petedelery2006/O.R.B.I.T-Project/hardware/models/README.md

# Current models: [O.R.B.I.T. 1.0](1.0/README.md)

The three models below are retained from the earlier prototype.

# Prototype models

Original STL data is preserved unchanged; filenames are simplified for repository use.

| Repository file | Original uploaded filename | Triangles |
| --- | --- | ---: |
| [prototype-floor.stl](prototype-floor.stl) | O.R.B.I.T 8 sensor prototype(floor)).stl | 6,740 |
| [prototype-front-wall.stl](prototype-front-wall.stl) | O.R.B.I.T 8 sensor prototype(front wall).stl | 1,034 |
| [sensor-test-tower.stl](sensor-test-tower.stl) | O.R.B.I.T sensor test tower.stl | 7,810 |

Each file passed a basic binary STL length/triangle-count check. This is not a printability, watertightness, dimensional accuracy, or mechanical-fit validation. STL files do not encode a standard physical unit; confirm scale in the slicer. Print settings, material, and editable source CAD files were not supplied.
