petedelery2006/O.R.B.I.T-Project/hardware/pcb/README.md

# Fan-control PCB

- [FAN control PCB1.pcb](FAN%20control%20PCB1.pcb) — supplied Pad2Pad design.
- [FAN control PCB1.bak](FAN%20control%20PCB1.bak) — supplied backup.

Both original files are preserved unchanged. Their SHA-256 hashes match in this snapshot. The file header identifies Pad2Pad; no schematic, Gerbers, fabrication rules check, or electrical validation was supplied. The parts notes separately report two protoboards for power rails and one for motor control; the files do not establish whether this PCB has been fabricated or installed.
