petedelery2006/O.R.B.I.T-Project/hardware/models/1.0/README.md

# O.R.B.I.T. 1.0 enclosure

Nine original binary STL files, preserved unchanged from the supplied files.

| Part / original filename | Triangles |
| --- | ---: |
| [O.R.B.I.T 1.0 (BACK WALL).stl](O.R.B.I.T%201.0%20%28BACK%20WALL%29.stl) | 1356 |
| [O.R.B.I.T 1.0 (BATTERY BASE).stl](O.R.B.I.T%201.0%20%28BATTERY%20BASE%29.stl) | 2652 |
| [O.R.B.I.T 1.0 (CONNECTER).stl](O.R.B.I.T%201.0%20%28CONNECTER%29.stl) | 3242 |
| [O.R.B.I.T 1.0 (FAN MOUNTS).stl](O.R.B.I.T%201.0%20%28FAN%20MOUNTS%29.stl) | 6144 |
| [O.R.B.I.T 1.0 (FRONT WALL).stl](O.R.B.I.T%201.0%20%28FRONT%20WALL%29.stl) | 15246 |
| [O.R.B.I.T 1.0 (LEFT WALL).stl](O.R.B.I.T%201.0%20%28LEFT%20WALL%29.stl) | 13714 |
| [O.R.B.I.T 1.0 (RIGHT WALL).stl](O.R.B.I.T%201.0%20%28RIGHT%20WALL%29.stl) | 844 |
| [O.R.B.I.T 1.0 (ROOF).stl](O.R.B.I.T%201.0%20%28ROOF%29.stl) | 830 |
| [O.R.B.I.T 1.0(BASE).stl](O.R.B.I.T%201.0%28BASE%29.stl) | 10146 |

All nine files passed binary STL length/triangle-count checks. STL has no standard physical unit; verify scale in the slicer. Material, orientation, supports, tolerances, and assembly fit have not been validated. Editable CAD source was not supplied.

The supplied spelling “CONNECTER” is retained. [Earlier prototype designs](../README.md) remain available for historical reference.
