petedelery2006/O.R.B.I.T-Project/docs/sensors-current.md

Parts

[Gas and Air Quality sensor](https://www.amazon.com/gp/product/B0B389LQCQ/ref=ewc_pr_img_16?smid=A1GMZO8N77UCMQ&psc=1)✅

[humidity sensor](https://www.amazon.com/Precision-Temperature-Humidity-Measurement-Communication/dp/B0F1JWWFT7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)✅

[magnetometer sensor](https://www.amazon.com/HiLetgo-LSM303DLHC-Compass-Accelerometer-Magnetometer/dp/B07X3GFKYD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)✅

[Arduino 2560](https://www.amazon.com/dp/B01H4ZLZLQ?ref=ppx_yo2ov_dt_b_fed_asin_title&th=1)✅

[16x02 LCD screen](https://www.amazon.com/dp/B0BWTFN9WF?ref=ppx_yo2ov_dt_b_fed_asin_title&th=1)3x✅

[ELEGOO 0.96 Inch OLED Display](https://www.amazon.com/dp/B0D2RMQQHR?ref=ppx_yo2ov_dt_b_fed_asin_title&th=1)2x✅

[Arduino Uno ATmega+328P ATMEGA+16U2](https://www.amazon.com/ELEGOO-Board-ATmega328P-ATMEGA16U2-Compliant/dp/B01EWOE0UU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)2x✅

[30mm Fan 5V](https://www.amazon.com/gp/product/B0792BW2VH/ref=ewc_pr_img_3?smid=A35AFW9EVJYR0N&th=1)2x✅

[6 Pin switch](https://www.amazon.com/gp/product/B0799NSBHY/ref=ewc_pr_img_9?smid=A2NNH5C5IP9N3O&th=1)✅

[12V/24V to 5V 5A 25W Buck Converter Power Regulator](https://www.amazon.com/gp/product/B0CSPTCT2H/ref=ewc_pr_img_11?smid=A2VHHX0QRT6DTE&th=1)2x✅                           

[Barometric Pressure and Altitude Sensor](https://www.amazon.com/gp/product/B013W0RR6Y/ref=ewc_pr_img_14?smid=AM0JQO74J587C&psc=1)✅

[5V 5AH Deep Cycle Battery](https://www.amazon.com/gp/product/B0FCG41L1H/ref=ewc_pr_img_11?smid=A2FTK1Z152QK5G&th=1)✅

[Visible Spectrum Infrared Color Spectrometer Sensor](https://www.amazon.com/gp/product/B0DBQKDV67/ref=ewc_pr_img_12?smid=A1ASY00QOMN6RD&psc=1)✅

[Fast-Blow Glass Fuses 4 amp](https://www.amazon.com/gp/product/B07WTVGSCF/ref=ox_sc_saved_title_5?smid=A2RFXKS6GNXFWP&th=1)✅

[RGB LED](https://github.com/petedelery2006/O.R.B.I.T-Project)✅

[Buzzer](https://github.com/petedelery2006/O.R.B.I.T-Project)✅

[INA219](https://www.amazon.com/dp/B07VL8NY32?ref=ppx_yo2ov_dt_b_fed_asin_title)✅

[2.42 inches 128x64 IIC I2C OLED](https://www.amazon.com/dp/B0G2RFLG1L?ref=ppx_yo2ov_dt_b_fed_asin_title&th=1)✅

[Mini Momentary Push Button](https://www.amazon.com/dp/B083JWJPW5?ref=ppx_yo2ov_dt_b_fed_asin_title&th=1)2x✅

2 PROTO Boards were used for power rails

1 PROTO Board was used for motor control
