petedelery2006/O.R.B.I.T-Project/docs/sensors-original.md

Parts

[Gas and Air Quality sensor](https://www.amazon.com/gp/product/B0B389LQCQ/ref=ewc_pr_img_16?smid=A1GMZO8N77UCMQ&psc=1)(not purchased)

[humidity sensor](https://www.amazon.com/Precision-Temperature-Humidity-Measurement-Communication/dp/B0F1JWWFT7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) and temp(tested in prototype)

[magnetometer sensor](https://www.amazon.com/HiLetgo-LSM303DLHC-Compass-Accelerometer-Magnetometer/dp/B07X3GFKYD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)(tested in prototype)

[O2 sensor](https://www.amazon.com/gp/product/B08BL1NLGV/ref=ewc_pr_img_4?smid=A2EH5PO307BR7O&th=1)(not purchased)

[Arduino 2560](https://www.amazon.com/dp/B01H4ZLZLQ?ref=ppx_yo2ov_dt_b_fed_asin_title&th=1)(tested in prototype)

[16x02 LCD screen](https://www.amazon.com/dp/B0BWTFN9WF?ref=ppx_yo2ov_dt_b_fed_asin_title&th=1)(tested in prototype)

[ELEGOO 0.96 Inch OLED Display](https://www.amazon.com/dp/B0D2RMQQHR?ref=ppx_yo2ov_dt_b_fed_asin_title&th=1)(tested in prototype)

[Arduino Uno ATmega+328P ATMEGA+16U2](https://www.amazon.com/ELEGOO-Board-ATmega328P-ATMEGA16U2-Compliant/dp/B01EWOE0UU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)(tested in prototype)

[30mm Fan 5V](https://www.amazon.com/gp/product/B0792BW2VH/ref=ewc_pr_img_3?smid=A35AFW9EVJYR0N&th=1)(not purchased)

[6 Pin switch](https://www.amazon.com/gp/product/B0799NSBHY/ref=ewc_pr_img_9?smid=A2NNH5C5IP9N3O&th=1)(not purchased)

[12V/24V to 5V 5A 25W Buck Converter Power Regulator](https://www.amazon.com/gp/product/B0CSPTCT2H/ref=ewc_pr_img_11?smid=A2VHHX0QRT6DTE&th=1)(not purchased)
