petedelery2006/O.R.B.I.T-Project/docs/parts-and-status.md

# Parts and status

Source: [current supplied sensors.md](sensors-current.md), received October 17, 2026. Every linked component is marked with a checkmark in that file. Checkmarks are reproduced as supplied status; they do not independently establish purchase, installation, or successful testing. Quantities default to unspecified when the notes give no count.

| Component (as supplied) | Quantity specified | Supplied status | Reference |
| --- | --- | --- | --- |
| Gas and Air Quality sensor | Not specified | Checkmarked | [Reference](https://www.amazon.com/gp/product/B0B389LQCQ/ref=ewc_pr_img_16?smid=A1GMZO8N77UCMQ&psc=1) |
| humidity sensor | Not specified | Checkmarked | [Reference](https://www.amazon.com/Precision-Temperature-Humidity-Measurement-Communication/dp/B0F1JWWFT7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) |
| magnetometer sensor | Not specified | Checkmarked | [Reference](https://www.amazon.com/HiLetgo-LSM303DLHC-Compass-Accelerometer-Magnetometer/dp/B07X3GFKYD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) |
| Arduino 2560 | Not specified | Checkmarked | [Reference](https://www.amazon.com/dp/B01H4ZLZLQ?ref=ppx_yo2ov_dt_b_fed_asin_title&th=1) |
| 16x02 LCD screen | 3 | Checkmarked | [Reference](https://www.amazon.com/dp/B0BWTFN9WF?ref=ppx_yo2ov_dt_b_fed_asin_title&th=1) |
| ELEGOO 0.96 Inch OLED Display | 2 | Checkmarked | [Reference](https://www.amazon.com/dp/B0D2RMQQHR?ref=ppx_yo2ov_dt_b_fed_asin_title&th=1) |
| Arduino Uno ATmega+328P ATMEGA+16U2 | 2 | Checkmarked | [Reference](https://www.amazon.com/ELEGOO-Board-ATmega328P-ATMEGA16U2-Compliant/dp/B01EWOE0UU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) |
| 30mm Fan 5V | 2 | Checkmarked | [Reference](https://www.amazon.com/gp/product/B0792BW2VH/ref=ewc_pr_img_3?smid=A35AFW9EVJYR0N&th=1) |
| 6 Pin switch | Not specified | Checkmarked | [Reference](https://www.amazon.com/gp/product/B0799NSBHY/ref=ewc_pr_img_9?smid=A2NNH5C5IP9N3O&th=1) |
| 12V/24V to 5V 5A 25W Buck Converter Power Regulator | 2 | Checkmarked | [Reference](https://www.amazon.com/gp/product/B0CSPTCT2H/ref=ewc_pr_img_11?smid=A2VHHX0QRT6DTE&th=1) |
| Barometric Pressure and Altitude Sensor | Not specified | Checkmarked | [Reference](https://www.amazon.com/gp/product/B013W0RR6Y/ref=ewc_pr_img_14?smid=AM0JQO74J587C&psc=1) |
| 5V 5AH Deep Cycle Battery | Not specified | Checkmarked | [Reference](https://www.amazon.com/gp/product/B0FCG41L1H/ref=ewc_pr_img_11?smid=A2FTK1Z152QK5G&th=1) |
| Visible Spectrum Infrared Color Spectrometer Sensor | Not specified | Checkmarked | [Reference](https://www.amazon.com/gp/product/B0DBQKDV67/ref=ewc_pr_img_12?smid=A1ASY00QOMN6RD&psc=1) |
| Fast-Blow Glass Fuses 4 amp | Not specified | Checkmarked | [Reference](https://www.amazon.com/gp/product/B07WTVGSCF/ref=ox_sc_saved_title_5?smid=A2RFXKS6GNXFWP&th=1) |
| RGB LED | Not specified | Checkmarked | [Reference](https://github.com/petedelery2006/O.R.B.I.T-Project) |
| Buzzer | Not specified | Checkmarked | [Reference](https://github.com/petedelery2006/O.R.B.I.T-Project) |
| INA219 | Not specified | Checkmarked | [Reference](https://www.amazon.com/dp/B07VL8NY32?ref=ppx_yo2ov_dt_b_fed_asin_title) |
| 2.42 inches 128x64 IIC I2C OLED | Not specified | Checkmarked | [Reference](https://www.amazon.com/dp/B0G2RFLG1L?ref=ppx_yo2ov_dt_b_fed_asin_title&th=1) |
| Mini Momentary Push Button | 2 | Checkmarked | [Reference](https://www.amazon.com/dp/B083JWJPW5?ref=ppx_yo2ov_dt_b_fed_asin_title&th=1) |

The notes also report **two protoboards for power rails** and **one protoboard for motor control**.

The firmware identifies the gas module as SGP30, climate sensor as AHT30, magnetic sensor as LSM303DLHC, pressure sensor as BMP280, and spectral sensor as AS7341. One Mega and two Uno sketches are supplied.

**Battery discrepancy:** the supplied list says “5V 5AH Deep Cycle Battery”; the Mega source assumes a 12 V 5 Ah LiFePO4 pack and uses 12.8 V nominal. Actual pack specification and installed quantity need confirmation.

Product links are retained as supplied references, not verified specifications or purchasing recommendations. RGB LED and buzzer entries link to this project rather than a specific product.

The [September original notes](sensors-original.md) remain as a historical snapshot. Their old unpurchased entries do not describe the current list. The O2 sensor appears only in those earlier notes and is absent from the current list and firmware.
