petedelery2006/O.R.B.I.T-Project/hardware/models/sensor-test-tower.stl

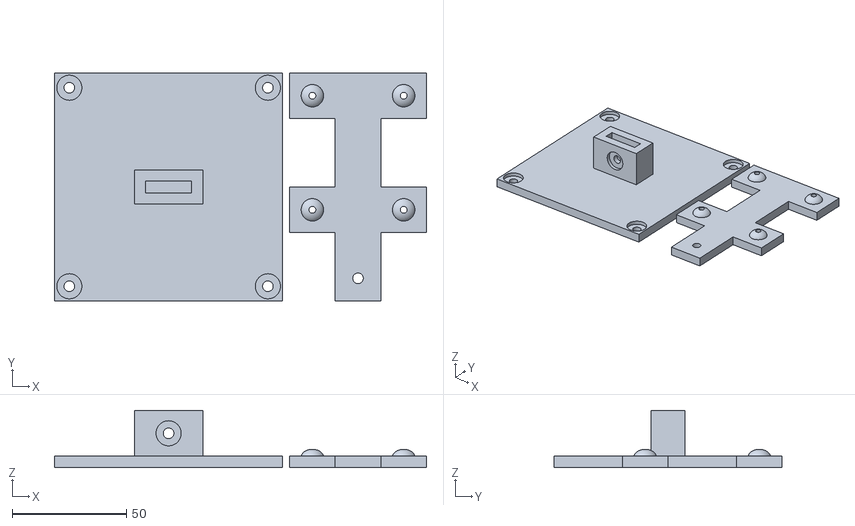
[picture p4: CAD file, 2026-09-10]
hardware/models/sensor-test-tower.stl
163.0 x 100.0 x 25.0
