petedelery2006/O.R.B.I.T-Project/hardware/models/1.0/O.R.B.I.T 1.0 (FRONT WALL).stl

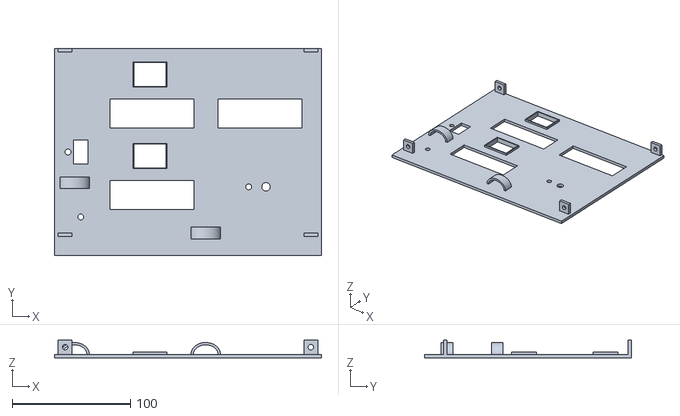
[picture p5: CAD file, 2026-10-17]
hardware/models/1.0/O.R.B.I.T 1.0 (FRONT WALL).stl
226.0 x 175.0 x 15.0
