petedelery2006/O.R.B.I.T-Project/hardware/models/prototype-floor.stl

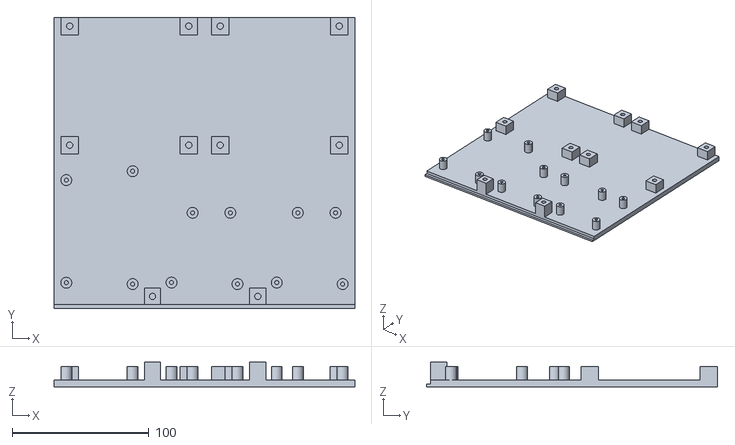
[picture p6: CAD file, 2026-09-10]
hardware/models/prototype-floor.stl
220.0 x 213.0 x 18.0
