petedelery2006/O.R.B.I.T-Project/hardware/models/1.0/O.R.B.I.T 1.0 (CONNECTER).stl

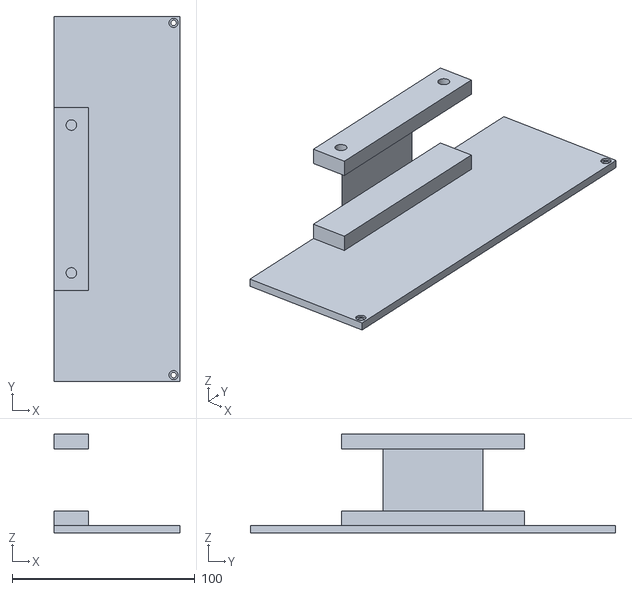
[picture p7: CAD file, 2026-10-17]
hardware/models/1.0/O.R.B.I.T 1.0 (CONNECTER).stl
69.0 x 200.0 x 54.0
