petedelery2006/O.R.B.I.T-Project/hardware/models/prototype-front-wall.stl

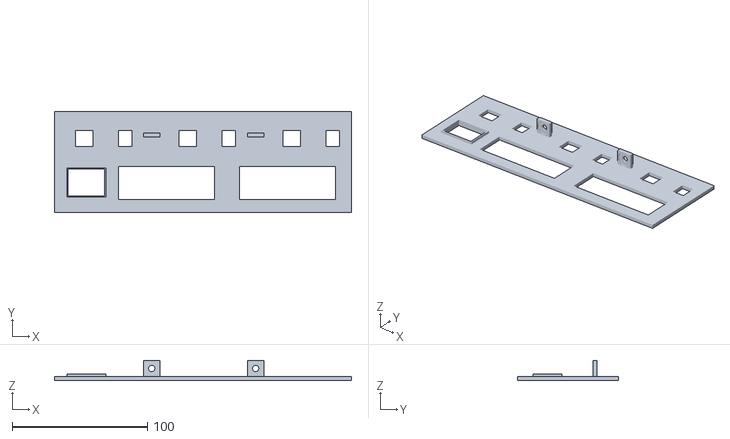
[picture p8: CAD file, 2026-09-10]
hardware/models/prototype-front-wall.stl
220.0 x 75.0 x 15.0
