petedelery2006/O.R.B.I.T-Project/hardware/models/1.0/O.R.B.I.T 1.0 (LEFT WALL).stl

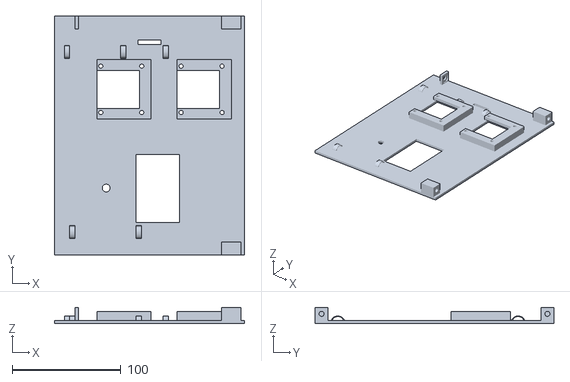
[picture p10: CAD file, 2026-10-17]
hardware/models/1.0/O.R.B.I.T 1.0 (LEFT WALL).stl
175.0 x 220.0 x 15.0
