petedelery2006/O.R.B.I.T-Project/hardware/models/1.0/O.R.B.I.T 1.0 (BATTERY BASE).stl

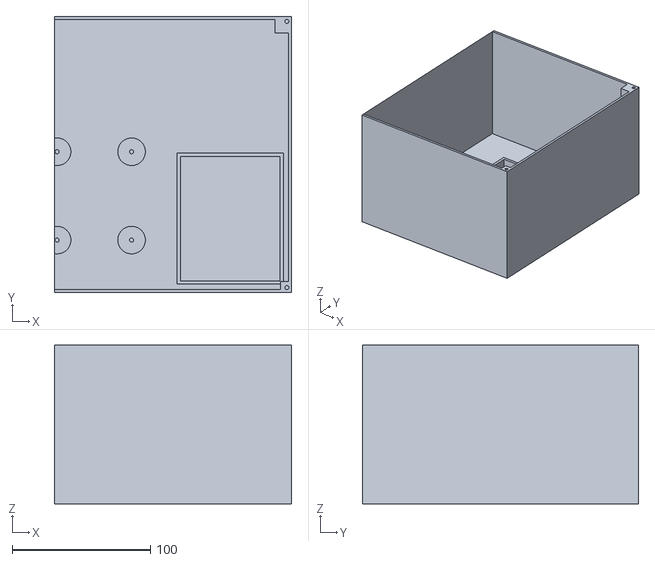
[picture p11: CAD file, 2026-10-17]
hardware/models/1.0/O.R.B.I.T 1.0 (BATTERY BASE).stl
172.0 x 200.0 x 115.0
