petedelery2006/O.R.B.I.T-Project/hardware/models/1.0/O.R.B.I.T 1.0(BASE).stl

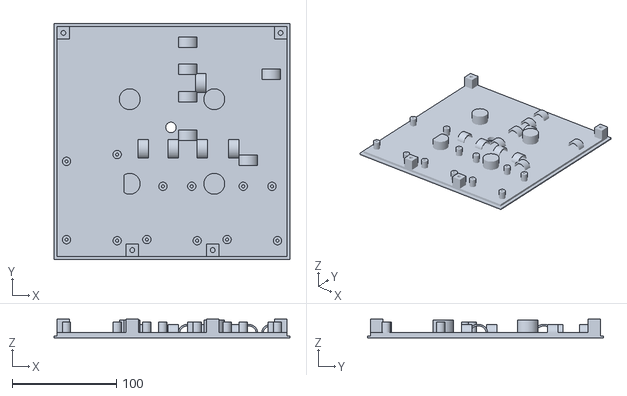
[picture p13: CAD file, 2026-10-17]
hardware/models/1.0/O.R.B.I.T 1.0(BASE).stl
226.0 x 226.0 x 18.0
