petedelery2006/O.R.B.I.T-Project/hardware/models/1.0/O.R.B.I.T 1.0 (FAN MOUNTS).stl

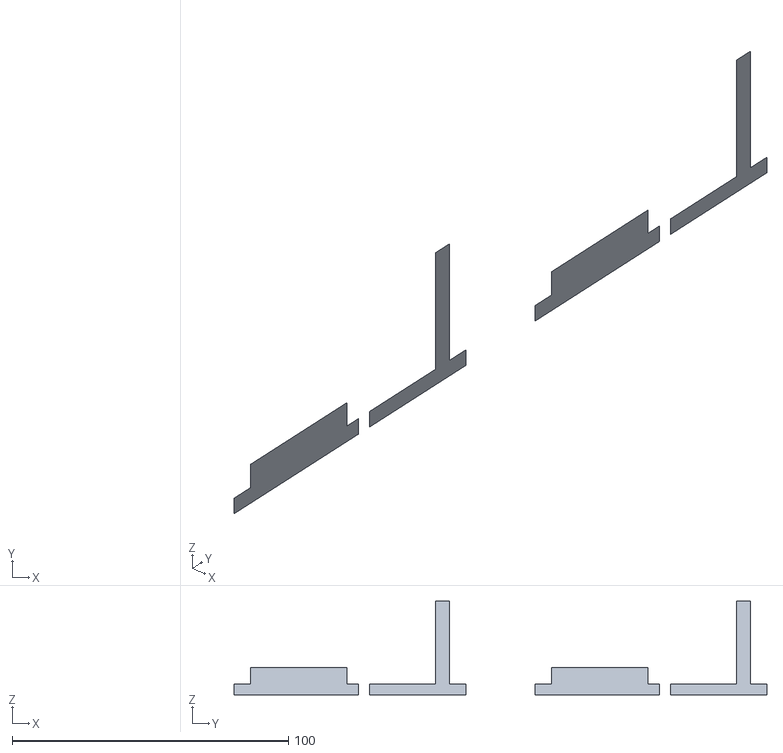
[picture p14: CAD file, 2026-10-17]
hardware/models/1.0/O.R.B.I.T 1.0 (FAN MOUNTS).stl
0 x 193.0 x 34.0
