petedelery2006/O.R.B.I.T-Project/(list of files, drawings)

Other design files:
hardware/pcb/FAN control PCB1.pcb
