petedelery2006/O.R.B.I.T-Project/firmware/ORBIT_Mega_Analog_I2C/ORBIT_Mega_Analog_I2C.ino

/* ORBIT Mega 2560 — SOFTWARE I2C: SDA=A4, SCL=A5.
   Move shared SDA from D20 to A4 and shared SCL from D21 to A5.
   Required libraries: U8g2, SoftwareWire (Testato), Adafruit BMP280 Library
   (install its Adafruit BusIO and Adafruit Unified Sensor dependencies).
   BMP280 ONLY: hardware I2C SDA=D20, SCL=D21; auto-detect 0x77 / 0x76.
   Keep the OLEDs and all existing software-I2C devices on A4/A5.
   D23 open: LCD temperature / humidity. Closed to GND: altitude / pressure.
   Altitude is estimated in feet using SEA_LEVEL_HPA below; pressure is hPa.
   Set SEA_LEVEL_HPA to local sea-level pressure (QNH) for calibrated altitude.
   BMP280 is local to the Mega; existing Uno UART protocol stays compatible.
   LCD=0x27, small OLED=0x3C, large OLED=0x3D, AHT30=0x38, INA219=0x40.
   INA219: assumes battery-side measurement and standard R100 shunt.
   One Fitinoch 12V 5Ah LiFePO4 battery; second pack is a spare.
   Percentage is a rough voltage estimate, NOT a calibrated fuel gauge.
   Usage totals reset at startup.
   RGB common cathode by default. EEPROM bytes 0..7 and 16..19 reserved.
   Sound settings: independent startup and air-sample tune, global mute.
   Home: strongest RAW AS7341 band; location/day-night are uncertain guesses.
   Debugging: tap D24 through information pages; hold Go back to return.
   Controls: D6 -> GND starts air sampling (dedicated button).
   D24 -> GND controls OLED: hold 2 seconds opens/selects; tap advances.
   D23 -> GND LCD switch; debounced state sent on UART1 AND UART3, 9600 baud.
   Serial1: TX=D18 -> Uno D10; RX=D19 <- Uno D11.
   Serial3: TX=D14 -> Uno D10; RX=D15 <- Uno D11. Common GND.
   Receiver sketches must parse SW=0/1 and SAMPLE=0/1 lines (see protocol).
   Fan animation lasts 6 seconds; physical fans retain their 30-second cycle.
   Battery time is a rough estimate from voltage, nominal capacity and load.
   Requires INA219 to measure ALL battery loads; not reliable while charging.
   Frame assets are adapted from the approved saved air-sample preview.
*/
#include <Arduino.h>
#include <string.h>
#include <stdlib.h>
#include <errno.h>
#include <SoftwareWire.h>
#include <Wire.h>
#include <Adafruit_BMP280.h>
#include <U8g2lib.h>
#include <EEPROM.h>
#include <avr/pgmspace.h>
#include <math.h>

const byte FAN1=49, FAN2=47, POWER_LED=43, RGB_G=41, RGB_B=39;
const byte FAN_BUTTON=6, BUZZER=38;
const bool RGB_COMMON_ANODE=false;
const unsigned long FAN_MS=30000UL, FLASH_MS=125UL;
const byte SDA_PIN=A4, SCL_PIN=A5;
SoftwareWire bus(SDA_PIN,SCL_PIN);
Adafruit_BMP280 bmp(&Wire);
const float SEA_LEVEL_HPA=1013.25f; // Standard reference, NOT current local QNH.
bool bmpOK=false, bmpValid=false, bmpSeen=false, bmpTimeoutSeen=false;
byte bmpAddress=0;
float pressureHPA=0, altitudeFT=0, bmpTempF=0;
unsigned long lastBMP=0, lastBMPGood=0, lastBMPAttempt=0;
uint16_t bmpErrors=0;
U8G2_SSD1306_128X64_NONAME_F_SW_I2C smallOLED(U8G2_R0,SCL_PIN,SDA_PIN,U8X8_PIN_NONE);
U8G2_SSD1309_128X64_NONAME2_F_SW_I2C largeOLED(U8G2_R0,SCL_PIN,SDA_PIN,U8X8_PIN_NONE);
bool lcdOK, smallOK, largeOK, ahtOK, inaOK;
bool climateValid=false, powerValid=false, powerOverflow=false;
bool climatePending=false;
float filteredBatteryV=0;
bool batteryEstimateReady=false;
float tempF=0, humidity=0, batteryV=0, currentMA=0, watts=0;
float usedMAh=0, usedWh=0;
bool fans=false;
unsigned long fanStarted=0, lastClimate=0, lastPower=0, lastDisplay=0;
unsigned long lastIntegration=0;
bool previousPowerValid=false;
float previousMA=0, previousW=0;

// Original first twelve audition tunes. Pairs: frequency Hz, duration ms.
const uint16_t t1[] PROGMEM={523,150,0,35,659,150,0,35,784,220,0,55,1047,450};
const uint16_t t2[] PROGMEM={784,110,0,90,784,110,0,180,1047,160,0,40,1319,330};
const uint16_t t3[] PROGMEM={523,90,587,90,659,90,784,90,880,90,1047,90,0,70,1568,300};
const uint16_t t4[] PROGMEM={659,260,0,100,988,260,0,100,784,260,0,100,740,200,659,500};
const uint16_t t5[] PROGMEM={523,70,784,70,1047,70,1319,70,1568,130,0,70,1319,100,1568,300};
const uint16_t t6[] PROGMEM={659,170,0,85,784,170,0,85,1047,280};
const uint16_t t7[] PROGMEM={523,110,0,190,523,110,0,190,784,110,0,120,1047,160,1319,160,1568,360};
const uint16_t t8[] PROGMEM={587,140,0,45,880,200,0,45,784,110,659,110,0,60,1175,400};
const uint16_t t9[] PROGMEM={1047,70,0,200,1319,70,0,200,1568,70,0,350,1047,70,0,200,1319,70,0,200,1568,70,0,350};
const uint16_t t10[] PROGMEM={523,65,587,65,659,65,784,65,880,65,784,65,659,65,587,65,0,250,523,65,587,65,659,65,784,65,880,65,784,65,659,65,587,65};
const uint16_t t11[] PROGMEM={880,65,0,95,880,65,0,310,1319,65,0,95,1319,65,0,310,880,65,0,95,1319,130};
const uint16_t t12[] PROGMEM={784,100,0,70,1047,160};
const uint16_t* const tunes[]={t1,t2,t3,t4,t5,t6,t7,t8,t9,t10,t11,t12};
#define WORDS(x) (sizeof(x)/sizeof(x[0]))
const uint16_t lengths[]={WORDS(t1),WORDS(t2),WORDS(t3),WORDS(t4),WORDS(t5),WORDS(t6),WORDS(t7),WORDS(t8),WORDS(t9),WORDS(t10),WORDS(t11),WORDS(t12)};
const uint16_t* sound=NULL;
uint16_t soundWords=0, soundPos=0;
unsigned long noteStarted=0, noteDuration=0;
bool soundRepeat=false;

// Startup logo: five 5x7 letters rise as separated pixels, then assemble.
const byte logoRows[5][7] PROGMEM={
  {14,17,17,17,17,17,14}, // O
  {30,17,17,30,20,18,17}, // R
  {30,17,17,30,17,17,30}, // B
  {31,4,4,4,4,4,31},     // I
  {31,4,4,4,4,4,4}      // T
};
const unsigned long LETTER_RISE_MS=650UL;
const unsigned long LOGO_ASSEMBLE_MS=900UL;
const unsigned long LOGO_HOLD_MS=800UL;
const unsigned long LOGO_RISE_END=5UL*LETTER_RISE_MS;
const unsigned long LOGO_TOTAL_MS=LOGO_RISE_END+LOGO_ASSEMBLE_MS+LOGO_HOLD_MS;
bool startupAnimating=true;
unsigned long startupAnimationStarted=0, lastAnimationFrame=0;

// Smoothstep in integer fixed-point: 0..256 in, 0..256 out.
uint16_t logoEase(unsigned long elapsed,unsigned long duration) {
  if(elapsed>=duration) return 256;
  uint32_t t=elapsed*256UL/duration;
  return (t*t*(768UL-2UL*t))/65536UL;
}
void renderStartupLogo(unsigned long elapsed) {
  largeOLED.clearBuffer();
  uint16_t assemble=elapsed>LOGO_RISE_END ?
    logoEase(elapsed-LOGO_RISE_END,LOGO_ASSEMBLE_MS):0;
  for(byte letter=0;letter<5;letter++) {
    unsigned long begins=(unsigned long)letter*LETTER_RISE_MS;
    if(elapsed<begins) continue;
    uint16_t rise=logoEase(elapsed-begins,LETTER_RISE_MS);
    // All geometry stays signed until pixels are clipped to the screen.
    int16_t top=64-(45L*rise+128)/256;
    int16_t startX=3+26*letter, finalX=14+21*letter;
    int16_t anchorX=startX+((long)(finalX-startX)*assemble)/256;
    int16_t anchorY=top+(3L*assemble+128)/256;
    int16_t stepQ=1024-assemble; // Pixel pitch: 4 -> 3 screen pixels.
    byte size=assemble<192?2:3;  // Final blocks join edge-to-edge.
    for(byte row=0;row<7;row++) {
      byte bits=pgm_read_byte(&logoRows[letter][row]);
      for(byte col=0;col<5;col++) if(bits&(1<<(4-col))) {
        int16_t x=anchorX+(col*stepQ+128)/256;
        int16_t y=anchorY+(row*stepQ+128)/256;
        if(x>=0 && x<128 && y>=0 && y<64) {
          byte w=min((int)size,128-x), h=min((int)size,64-y);
          largeOLED.drawBox(x,y,w,h);
        }
      }
    }
  }
}


// Bitmaps stay in flash, not the Mega's 8 KB RAM.
const byte AIR_FRAME_COUNT=40;
const uint8_t airFramesA[20][1024] PROGMEM={
  {0x00,0x00,0x00,0x00,0x00,0x00,0x00,0x00,0x00,0x00,0x00,0x00,0x00,0x00,0x00,0x00,0x00,0x00,0x00,0x00,0x00,0x00,0x00,0x00,0x00,0x00,0x00,0x00,0x00,0x00,0x00,0x00,0x00,0x00,0x00,0x00,0x00,0x00,0x00,0x00,0x00,0x00,0x00,0x00,0x00,0x00,0x00,0x00,0x00,0x00,0x00,0x00,0x00,0x00,0x00,0x00,0x00,0x00,0x00,0x00,0x00,0x00,0x00,0x00,0x00,0x00,0x00,0x00,0x00,0x00,0x00,0x00,0x00,0x00,0x00,0x00,0x00,0x00,0x00,0x00,0x00,0x00,0x00,0x00,0x00,0x00,0x00,0x00,0x00,0x00,0x00,0x00,0x00,0x00,0x00,0x00,0x00,0x00,0x00,0x00,0x00,0x00,0x00,0x00,0x00,0x00,0x00,0x00,0x00,0x00,0x00,0x00,0x00,0x00,0x00,0x00,0x00,0x00,0x00,0x00,0x00,0x00,0x00,0x00,0x00,0x00,0x00,0x00,0x00,0x00,0x00,0x00,0x00,0x00,0x00,0x00,0x00,0x00,0x00,0x00,0x00,0x00,0x00,0x00,0x00,0x00,0x00,0x00,0x00,0x00,0x00,0x00,0x00,0x00,0x00,0x00,0x00,0x00,0x00,0x00,0x00,0x00,0x00,0x00,0x00,0x00,0x00,0x00,0x00,0x00,0x00,0x00,0x00,0x00,0x00,0x00,0x00,0x00,0x00,0x00,0x00,0x00,0x00,0x00,0x00,0x00,0x00,0x00,0x00,0x00,0x00,0x00,0x00,0x00,0x00,0x00,0x00,0x00,0x00,0x00,0x00,0x00,0x00,0x00,0x00,0x00,0x00,0x00,0x00,0x00,0x00,0x00,0x00,0x00,0x00,0x00,0x00,0x00,0x00,0x00,0x00,0x00,0x00,0x00,0x00,0x00,0x00,0x00,0x00,0x00,0x00,0x00,0x00,0x00,0x00,0x00,0x00,0x00,0x00,0x00,0x00,0x00,0x00,0x00,0x00,0x00,0x00,0x00,0x00,0x00,0x00,0x00,0x00,0x00,0x00,0x00,0x00,0x00,0x00,0x00,0x00,0x00,0x00,0x00,0x00,0x00,0x00,0x00,0x00,0x00,0x00,0x00,0x00,0x00,0x00,0x00,0x00,0x00,0x00,0x00,0x00,0x00,0x00,0x00,0x00,0x00,0x00,0x00,0x00,0x00,0x00,0x00,0x00,0x00,0x00,0x00,0x00,0x00,0x00,0x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
        sendOLED(largeOLED);
      }
      return;
    }
    startupAnimating=false;
    lastDisplay=millis()-1000UL;
  }
  if(millis()-lastDisplay>=1000UL) {lastDisplay=millis(); drawDisplays();}
  // Keep animation independent of the slower LCD/environment refresh.
  // The software-I2C transfer rate determines the achievable frame rate.
  if(largeOK && millis()-lastLargeFrame>=120UL) {
    lastLargeFrame=millis();renderLargeUI();sendOLED(largeOLED);
  }
}
