petedelery2006/O.R.B.I.T-Project/(commit log)

2026-09-10 Initialize ORBIT prototype documentation
2026-09-10 Archive prototype models, parts inventory, and ORBIT progress
    [prototype-floor.stl, prototype-front-wall.stl, sensor-test-tower.stl]
2026-10-17 Update ORBIT 1.0 project page, firmware, enclosure and PCB files
    [FAN control PCB1.pcb, O.R.B.I.T 1.0 (BACK WALL).stl, O.R.B.I.T 1.0 (BATTERY BASE).stl, O.R.B.I.T 1.0 (CONNECTER).stl, O.R.B.I.T 1.0 (FAN MOUNTS).stl, O.R.B.I.T 1.0 (FRONT WALL).stl, O.R.B.I.T 1.0 (LEFT WALL).stl, O.R.B.I.T 1.0 (RIGHT WALL).stl]
